shawnlinhca/vigilant-garbanzo/docs/training_curve.png

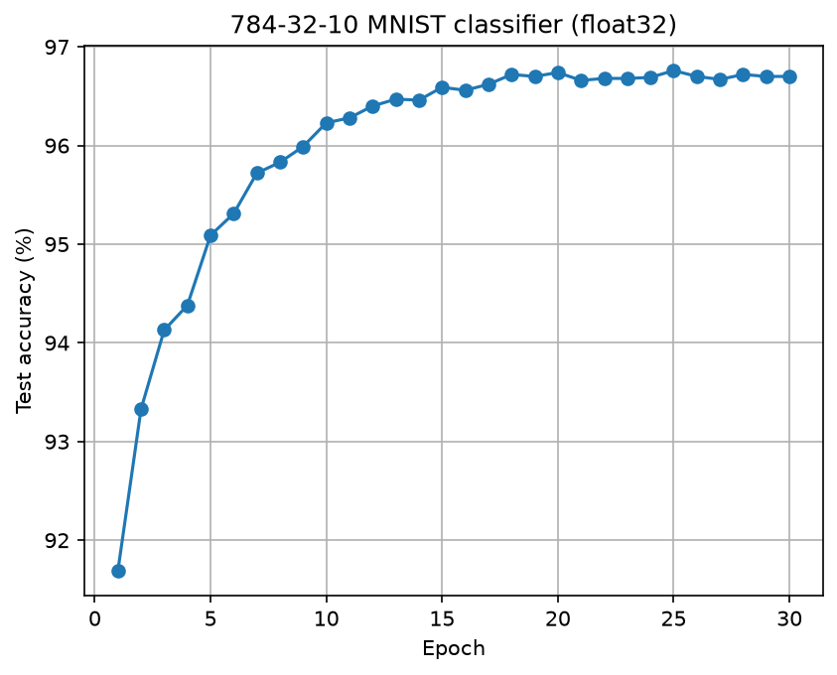
docs/training_curve.png
