shawnlinhca/vigilant-garbanzo/constraints/board_top.xdc

## Basys 3 constraints for board_top (pins copied from Digilent's master XDC by script).
## (basys3.xdc holds the pins for the old switches-to-LEDs `top` warm-up and is not used by board_top.)

## Clock (100 MHz)
set_property -dict { PACKAGE_PIN W5   IOSTANDARD LVCMOS33 } [get_ports clk]
create_clock -add -name sys_clk_pin -period 10.00 -waveform {0 5} [get_ports clk]

## Reset button (center) and USB-UART
set_property -dict { PACKAGE_PIN U18  IOSTANDARD LVCMOS33 } [get_ports btnC]
set_property -dict { PACKAGE_PIN B18  IOSTANDARD LVCMOS33 } [get_ports RsRx]
set_property -dict { PACKAGE_PIN A18  IOSTANDARD LVCMOS33 } [get_ports RsTx]

## LEDs
set_property -dict { PACKAGE_PIN U16  IOSTANDARD LVCMOS33 } [get_ports {led[0]}]
set_property -dict { PACKAGE_PIN E19  IOSTANDARD LVCMOS33 } [get_ports {led[1]}]
set_property -dict { PACKAGE_PIN U19  IOSTANDARD LVCMOS33 } [get_ports {led[2]}]
set_property -dict { PACKAGE_PIN V19  IOSTANDARD LVCMOS33 } [get_ports {led[3]}]
set_property -dict { PACKAGE_PIN W18  IOSTANDARD LVCMOS33 } [get_ports {led[4]}]
set_property -dict { PACKAGE_PIN U15  IOSTANDARD LVCMOS33 } [get_ports {led[5]}]
set_property -dict { PACKAGE_PIN U14  IOSTANDARD LVCMOS33 } [get_ports {led[6]}]
set_property -dict { PACKAGE_PIN V14  IOSTANDARD LVCMOS33 } [get_ports {led[7]}]
set_property -dict { PACKAGE_PIN V13  IOSTANDARD LVCMOS33 } [get_ports {led[8]}]
set_property -dict { PACKAGE_PIN V3   IOSTANDARD LVCMOS33 } [get_ports {led[9]}]
set_property -dict { PACKAGE_PIN W3   IOSTANDARD LVCMOS33 } [get_ports {led[10]}]
set_property -dict { PACKAGE_PIN U3   IOSTANDARD LVCMOS33 } [get_ports {led[11]}]
set_property -dict { PACKAGE_PIN P3   IOSTANDARD LVCMOS33 } [get_ports {led[12]}]
set_property -dict { PACKAGE_PIN N3   IOSTANDARD LVCMOS33 } [get_ports {led[13]}]
set_property -dict { PACKAGE_PIN P1   IOSTANDARD LVCMOS33 } [get_ports {led[14]}]
set_property -dict { PACKAGE_PIN L1   IOSTANDARD LVCMOS33 } [get_ports {led[15]}]

## Seven-segment display
set_property -dict { PACKAGE_PIN W7   IOSTANDARD LVCMOS33 } [get_ports {seg[0]}]
set_property -dict { PACKAGE_PIN W6   IOSTANDARD LVCMOS33 } [get_ports {seg[1]}]
set_property -dict { PACKAGE_PIN U8   IOSTANDARD LVCMOS33 } [get_ports {seg[2]}]
set_property -dict { PACKAGE_PIN V8   IOSTANDARD LVCMOS33 } [get_ports {seg[3]}]
set_property -dict { PACKAGE_PIN U5   IOSTANDARD LVCMOS33 } [get_ports {seg[4]}]
set_property -dict { PACKAGE_PIN V5   IOSTANDARD LVCMOS33 } [get_ports {seg[5]}]
set_property -dict { PACKAGE_PIN U7   IOSTANDARD LVCMOS33 } [get_ports {seg[6]}]
set_property -dict { PACKAGE_PIN V7   IOSTANDARD LVCMOS33 } [get_ports dp]
set_property -dict { PACKAGE_PIN U2   IOSTANDARD LVCMOS33 } [get_ports {an[0]}]
set_property -dict { PACKAGE_PIN U4   IOSTANDARD LVCMOS33 } [get_ports {an[1]}]
set_property -dict { PACKAGE_PIN V4   IOSTANDARD LVCMOS33 } [get_ports {an[2]}]
set_property -dict { PACKAGE_PIN W4   IOSTANDARD LVCMOS33 } [get_ports {an[3]}]

## Configuration voltage (avoids a DRC warning)
set_property CFGBVS VCCO [current_design]
set_property CONFIG_VOLTAGE 3.3 [current_design]
