shawnlinhca/vigilant-garbanzo/(commit log)

2026-10-16 Add switches-to-LEDs warm-up, testbench, and sim script
2026-10-23 Add synthesis flow; baseline results: 1726 LUTs, 9.5 BRAM, 0 DSPs, timing met at 100 MHz
2026-10-23 Register hidden activations to fix critical path; meets 125 MHz target (+0.85 ns slack)
    [network.sv]
2026-10-23 Add UART receiver (8N1, 115200 baud) with self-checking testbench
2026-10-23 Add UART loader: image write, auto-start, and resync on error/stall/busy
    [tb_uart_loader.sv, uart_loader.sv]
2026-10-23 Add UART transmitter and seven-segment driver with self-checking testbenches
2026-10-23 Add board_top, end-to-end testbench, board constraints, and full build; timing met at 100 MHz
2026-10-23 On-board validation: 96.73% accuracy on 10,000 images, identical to the golden model
2026-10-23 Add board demo photo to README
